frangulus/Vorlesegeraet/Documentation/HugoTastatur.jpg

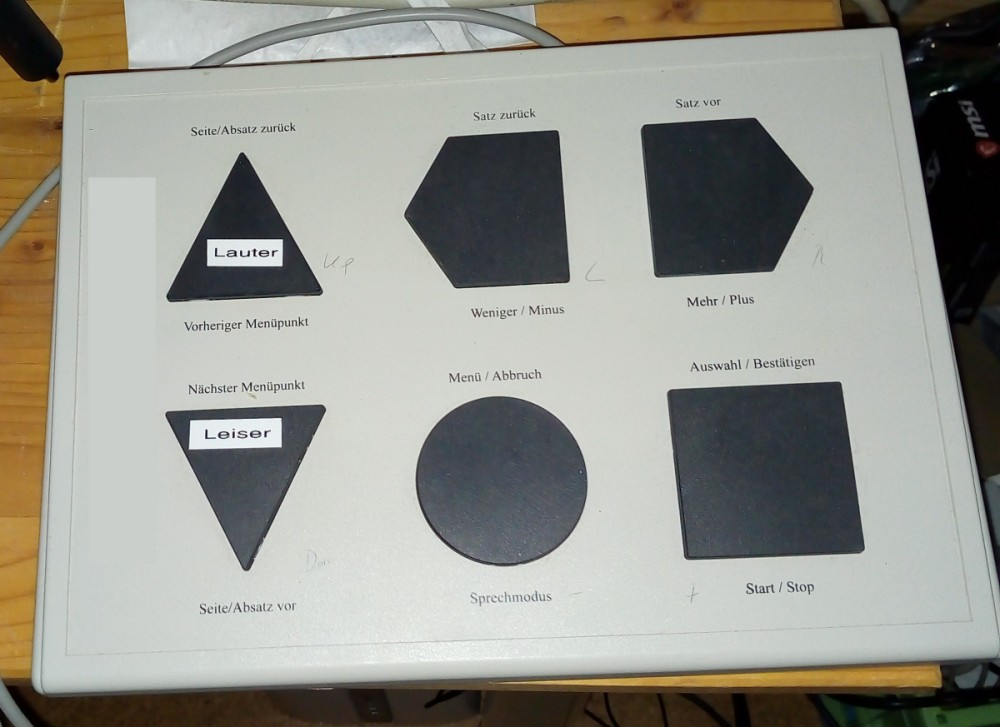
Documentation/HugoTastatur.jpg
