frangulus/Vorlesegeraet/Documentation/HugoFront.jpg

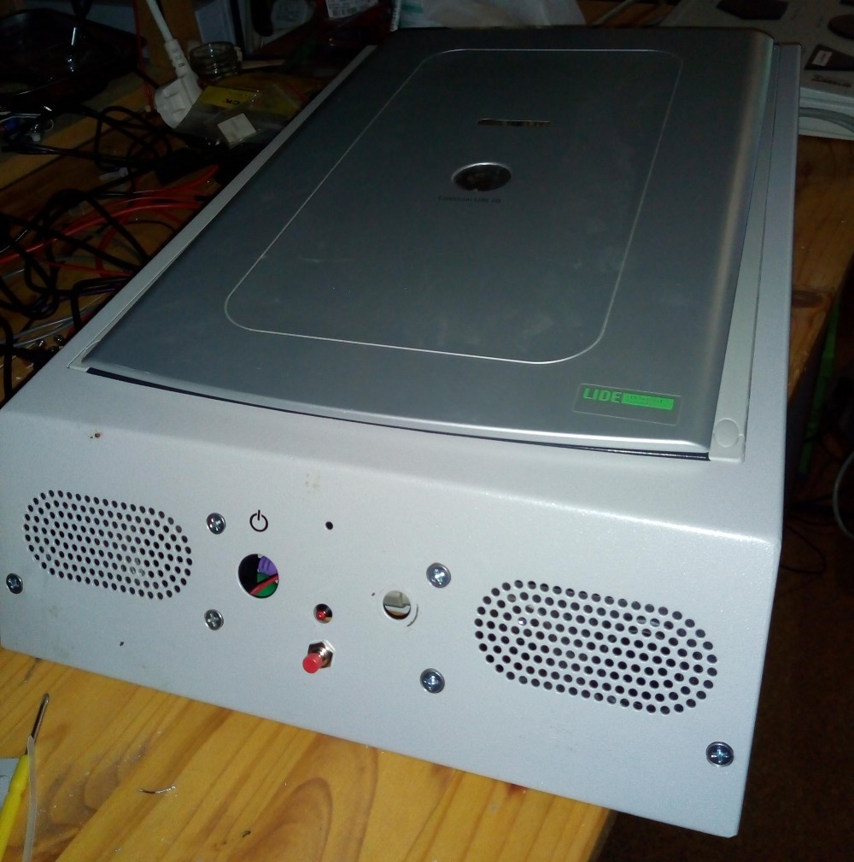
Documentation/HugoFront.jpg
